QQBoxy/fanboxy/fanboxy.ino

#include <ESP8266WiFi.h>
#include <PubSubClient.h>

const char *ssid = "YOUR_WIFI_SSID";
const char *password = "YOUR_WIFI_PASSWORD";
const char *mqtt_server = "YOUR_MQTT_SERVER";
const char *mqtt_name = "YOUR_MQTT_SERVER_NAME";
const char *mqtt_password = "YOUR_MQTT_SERVER_PASSWORD";

WiFiClient espClient;
PubSubClient client(espClient);
unsigned long lastMsg = 0;
#define MSG_BUFFER_SIZE (50)
char msg[MSG_BUFFER_SIZE];
int value = 0;

void setup_wifi()
{

    delay(10);
    Serial.println();
    Serial.print("Connecting to ");
    Serial.println(ssid);

    WiFi.mode(WIFI_STA);
    WiFi.begin(ssid, password);

    while (WiFi.status() != WL_CONNECTED)
    {
        delay(500);
        Serial.print(".");
    }

    randomSeed(micros());

    Serial.println("");
    Serial.println("WiFi connected");
    Serial.println("IP address: ");
    Serial.println(WiFi.localIP());
}

void callback(char *topic, byte *payload, unsigned int length)
{
    Serial.print("Message arrived [");
    Serial.print(topic);
    Serial.print("] ");
    for (int i = 0; i < length; i++)
    {
        Serial.print((char)payload[i]);
    }
    Serial.println();

    if ((char)payload[0] == '1')
    {
        digitalWrite(0, HIGH);
        snprintf(msg, MSG_BUFFER_SIZE, "%ld", 1);
    }
    else
    {
        digitalWrite(0, LOW);
        snprintf(msg, MSG_BUFFER_SIZE, "%ld", 0);
    }
}

void reconnect()
{
    while (!client.connected())
    {
        Serial.print("Attempting MQTT connection...");
        String clientId = "ESP8266Client-";
        clientId += String(random(0xffff), HEX);
        if (client.connect(clientId.c_str(), mqtt_name, mqtt_password))
        {
            Serial.println("connected");
            client.publish("fanboxy/power/outTopic", "0");
            client.subscribe("fanboxy/power/inTopic");
        }
        else
        {
            Serial.print("failed, rc=");
            Serial.print(client.state());
            Serial.println(" try again in 5 seconds");
            delay(5000);
        }
    }
}

void setup()
{
    pinMode(0, OUTPUT);
    Serial.begin(115200);
    setup_wifi();
    client.setServer(mqtt_server, 1883);
    client.setCallback(callback);
}

void loop()
{

    if (!client.connected())
    {
        reconnect();
    }
    client.loop();

    unsigned long now = millis();
    if (now - lastMsg > 2000)
    {
        lastMsg = now;
        ++value;
        client.publish("fanboxy/power/outTopic", msg);
    }
}
